igg/BBD9000/Kiosk/SmartIO/hardware/v3.3/SmartIOv3.3-brd.png

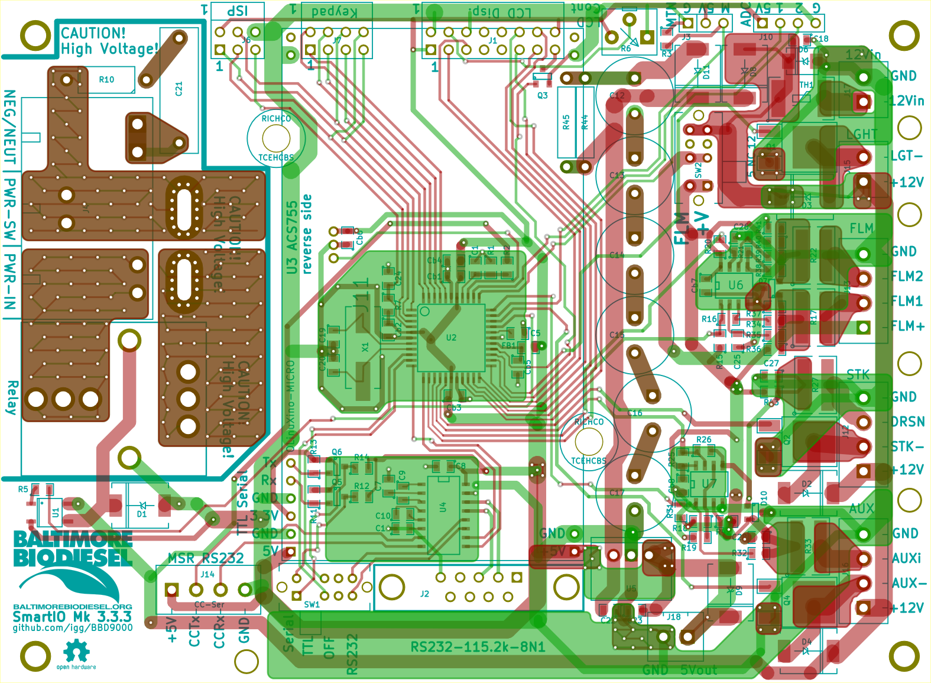
Kiosk/SmartIO/hardware/v3.3/SmartIOv3.3-brd.png
