igg/BBD9000/Kiosk/README.md

#### ARM-SBC
* Software running on a single-board solid-state Linux computer for interfacing between SmartIO board and BBD9000-CMS.

#### SmartIO
* Hardware design files and AVR firmware
