igg/BBD9000/Kiosk/SmartIO/hardware/README.md

### SmartIO v3.2
  * Original board manufactured by Baltimore Biodiesel Coop.
  * Through-hole, hand-soldered design.
  * PC-104 form-factor.
  * Requires external PC-104 5V power supply board.
  * Pad2Pad proprietary design files.

### SmartIO v3.3 and beyond
  * Designed using [KiCad EDA software] (http://www.kicad-pcb.org/) (free/open-source, Mac, Linux, Windows)
  * Mostly SMT components
  * Header/footprint for newer ARM CPU board (currently [Olimex iMX233-OLinuXino-Micro] (https://www.olimex.com/Products/OLinuXino/iMX233/iMX233-OLinuXino-MICRO/))
  * TTL-serial comms with ARM CPU via header (on board TTL voltage level shifter)
  * On-board 5V 2A switching power supply module, supplies ARM CPU via header
