igg/BBD9000/Kiosk/Case/Panel-AM1084-8-hole-no-components.pdf

Origin

Cutout: Square
X=9.100"; Y=10.145"
W = 0.20"; H = 0.20"

Cutout: Square
X=3.700"; Y=10.145"
W = 0.20"; H = 0.20"

r = 0.40"

## Round-corner panel 14 ga. (alt: 12 ga.) Stainless

W = 13.00"; H = 11.12" (-0.0"/+0.1")

## Corner radius = 0.40"

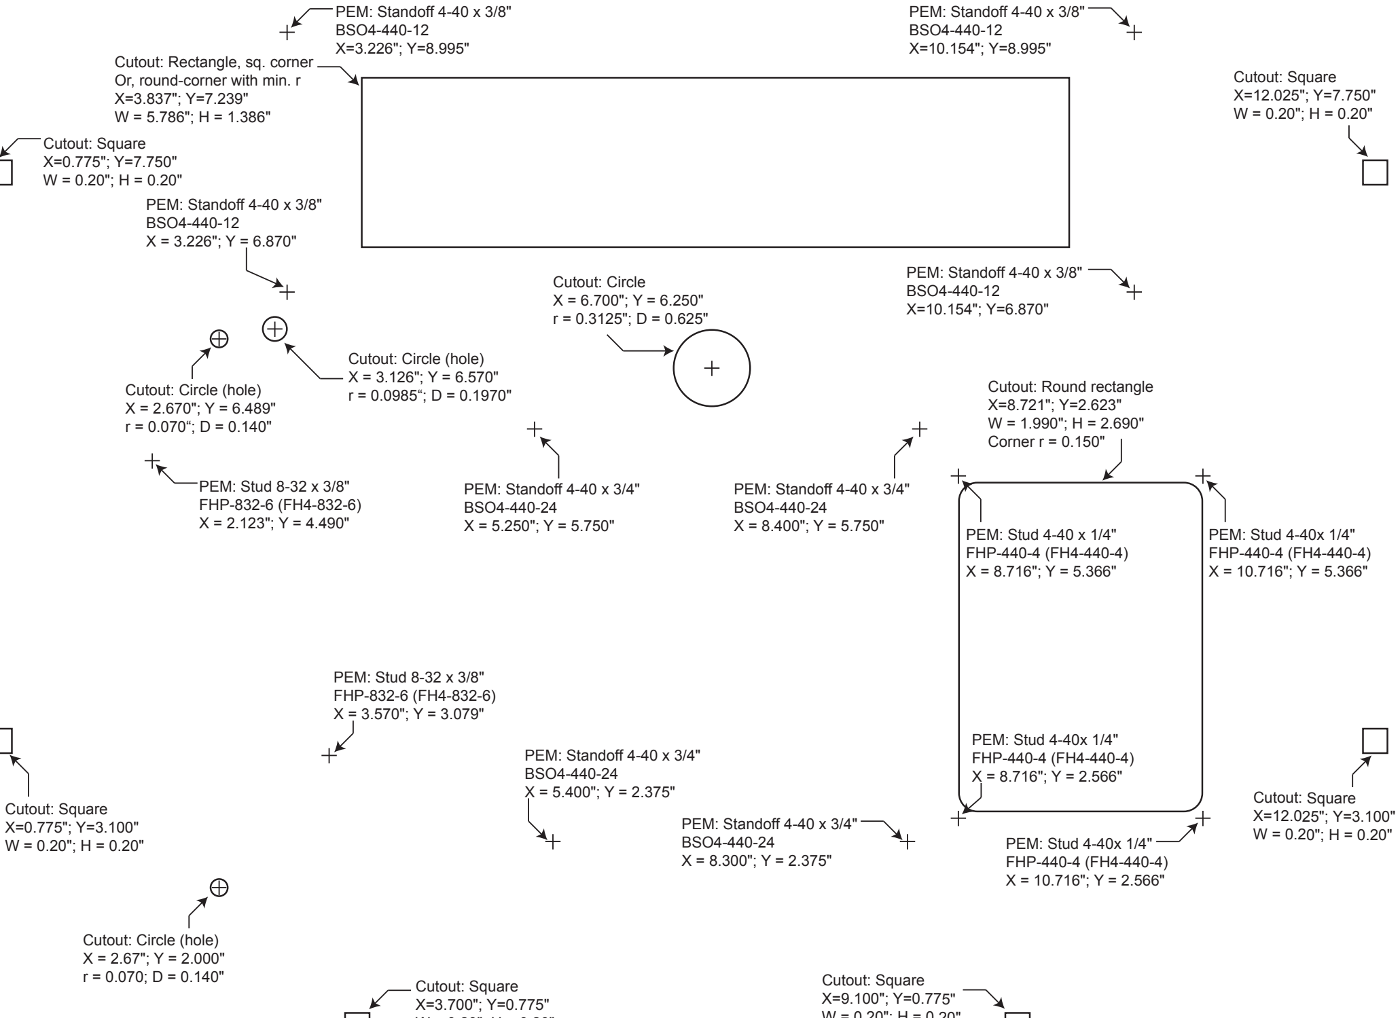
[picture p3: figure]
Cutout: Square X=0.775"; Y=7.750" W = 0.20"; H = 0.20"; PEM: Standoff 4-40 x 3/8" BSO4-440-12 X=3.226"; Y=8.995"; PEM: Standoff 4-40 x 3/8" BSO4-440-12 X=10.154"; Y=8.995"; PEM: Standoff 4-40 x 3/8" BSO4-440-12 X=10.154"; Y=6.870"; PEM: Standoff 4-40 x 3/8" BSO4-440-12 X = 3.226"; Y = 6.870"; Cutout: Rectangle, sq. corner Or, round-corner with min. r X=3.837"; Y=7.239" W = 5.786"; H = 1.386"; Cutout: Circle X = 6.700"; Y = 6.250" r = 0.3125"; D = 0.625"; PEM: Stud 8-32 x 3/8" FHP-832-6 (FH4-832-6) X = 2.123"; Y = 4.490"; PEM: Stud 8-32 x 3/8" FHP-832-6 (FH4-832-6) X = 3.570"; Y = 3.079"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

W = 0.20"; H = 0.20"

W = 0.20"; H = 0.20"

NOTE: Face-on view; PEMs stick out the back side.
* Origin at lower-left.
* PEM positions are to the center of the PEM.
* Round cutout positions are to the center of the cutout.
* Square cutout positions to the lower-left corner of the cutout.
