igg/BBD9000/Kiosk/SmartIO/hardware/v3.3/SmartIOv3.3-BOM.ods

Id | Designator | Package | Quantity | Designation | Supplier and ref | Alt | New in 3.3.2
Power switching
2 | K1 | relay-CB1AH | 1 | CB1aH-P-12V | 255-2177-ND
43 | J4 | MOLEX-39910-0103-3circ | 1 | 39910-0103 | WM5965-ND
Terminals
26 | J12,J13,J14,J16 | OSTTE-4 | 4 | STK, FLM, CC-Ser, AUX | ED2742-ND |  | *
32 | J15,J17,J18 | OSTTE-2 | 3 | LGHT, 12Vin, 5Vou | ED2740-ND |  | *
5 | J2 | DB9FD | 1 | DB9
Through-hole
44 | R10 | R4 | 1 | 120 | RC12JB100R-ND
45 | C21 | C-X2-15mm | 1 | 0.1uF | 399-5426-ND
48 | R6 | POTX | 1 | 10k | DCA14CT-ND
25 | C12,C13,C14,C15,C16,C17 | C2V10 | 6 | 10F | 1182-1009-ND
46 | U3 | Allegro_HallSensor_CB-PFF | 1 | ACS758LCB-050U | 620-1353-ND
34 | U5 | V78XX-2000 | 1 | 5V-2A-PSU-V7805-2000 | 102-2175-ND
1 | SW1,SW2 | SW_DP3T | 2 | SW-DP3T | EG1913-ND |  | *
Headers,male 2-row, right-angle 30-pos total |  |  |  |  | A32706-40-ND |  | *
36 | J1 | pin_array_8x2_ra | 1 | LCD
50 | J6 | pin_array_3x2_ra | 1 | ISP Hdr
35 | J7 | pin_array_4x2_ra | 1 | Keypad
Headers, male 1-row male 7-pos total |  |  |  |  | A26513-40-ND
33 | J3 | PIN_ARRAY_3X1 | 1 | MTN
23 | J10 | PIN_ARRAY_4x1 | 1 | ADC
Headers, female 1-row 3x2-pos, 1x6-pos
42 | J11 | OLinuXino-MICRO-min | 1 | TTL UART | S7039-ND | 3M9517-ND
-- | Jxx | header-f-1x2-pth | 3 | 2x1 mounting headers | S7035-ND
SMD components
20 | X1 | HC49-US | 1 | 18.432 MHz | 631-1209-1-ND
3 | U1 | SOP4 | 1 | CPC1002N | CLA230CT-ND
47 | U2 | TQFP44-ATMega324 | 1 | ATMEGA324PA-A | ATMEGA324PA-AURCT-ND
4 | U4 | SO16N | 1 | MAX232 | 296-26141-1-ND
6 | U6,U7 | LM193 | 2 | LM193 | 296-31647-1-ND |  | *
22 | TH1 | PTC2920 | 1 | PTC-3A | MF-LSMF300/24X-2CT-ND |  | *
24 | Q1,Q2,Q4 | DPAK2 | 3 | NTD5806NT4G | NTD5806NT4GOSCT-ND |  | *
37 | Q3,Q5,Q6 | SOT23-BSS138K | 3 | BSS138K | BSS138KCT-ND
21 | D6 | DO-214AA-TVS | 1 | TVS-13V | 1SMB13AT3GOSCT-ND |  | *
8 | D7,D10 | SOT23 | 2 | TVS-15V | GSOT15C-GS08CT-ND |  | *
38 | D1,D2,D3,D4,D8,D9 | DO-214AB | 6 | STPS5L60 | 497-8487-1-ND |  | *
7 | R17,R22,R27,R33 | SM2512W-1225 | 4 | 5k 2W PR | RCL4.99KECT-ND |  | *
9 | R2,R7,R11,R12,R13,R14,R19 | SM0805 | 7 | 10k | RR12P10.0KDCT-ND
10 | R1 | SM0805 | 1 | 3.4k | RR12P3.4KDCT-ND
11 | Cb1,Cb2,Cb3,Cb5,Cb6,Cb7,Cb8,C1,C5,C24 | SM0805 | 10 | 0.1uF | 1276-1007-1-ND
12 | Cb4,C18,C22 | SM0805 | 3 | 10uF | 490-5523-1-ND
13 | FB1 | SM0805 | 1 | 1kOhm@100MHz | 490-1041-1-ND
14 | R5 | SM0805 | 1 | 1k | RR12P1.0KDCT-ND
15 | C7,C8,C9,C10,C11 | SM0805 | 5 | 1uF | 311-1358-1-ND
16 | C19,C20 | SM0805 | 2 | 22pF | 399-1113-1-ND
17 | R3,R16,R21,R26,R32 | SM0805 | 5 | 56.2k | RR12P56.2KDCT-ND
18 | C23 | SM0805 | 1 | 22uF | 1276-2910-1-ND | 445-14428-1-ND
19 | C25,C26,C27,C28 | SM0805 | 4 | 0.2uF 50V | 1276-2948-1-ND | 0.02 uF: 1276-1081-1-ND | *
20 | R15,R18,R20,R25,R31,R34-R43 | SM0805 | 15 | 5k | RR12P5.1KDCT-ND |  | *
 |  | SMD components | 81
 |  | Through-hole | 32
Keypad connection
 | 8-pos 1-row 0.1” female, back of keypad | A31000-ND
 | 8-pos 2-row female for board header | 609-3570-ND
 | 8-pos ribbon cable 0.05”, 28 AWG | MD08R-5-ND
