igg/BBD9000/Kiosk/SmartIO/hardware/v3.3/SmartIOv3.3-sch.pdf

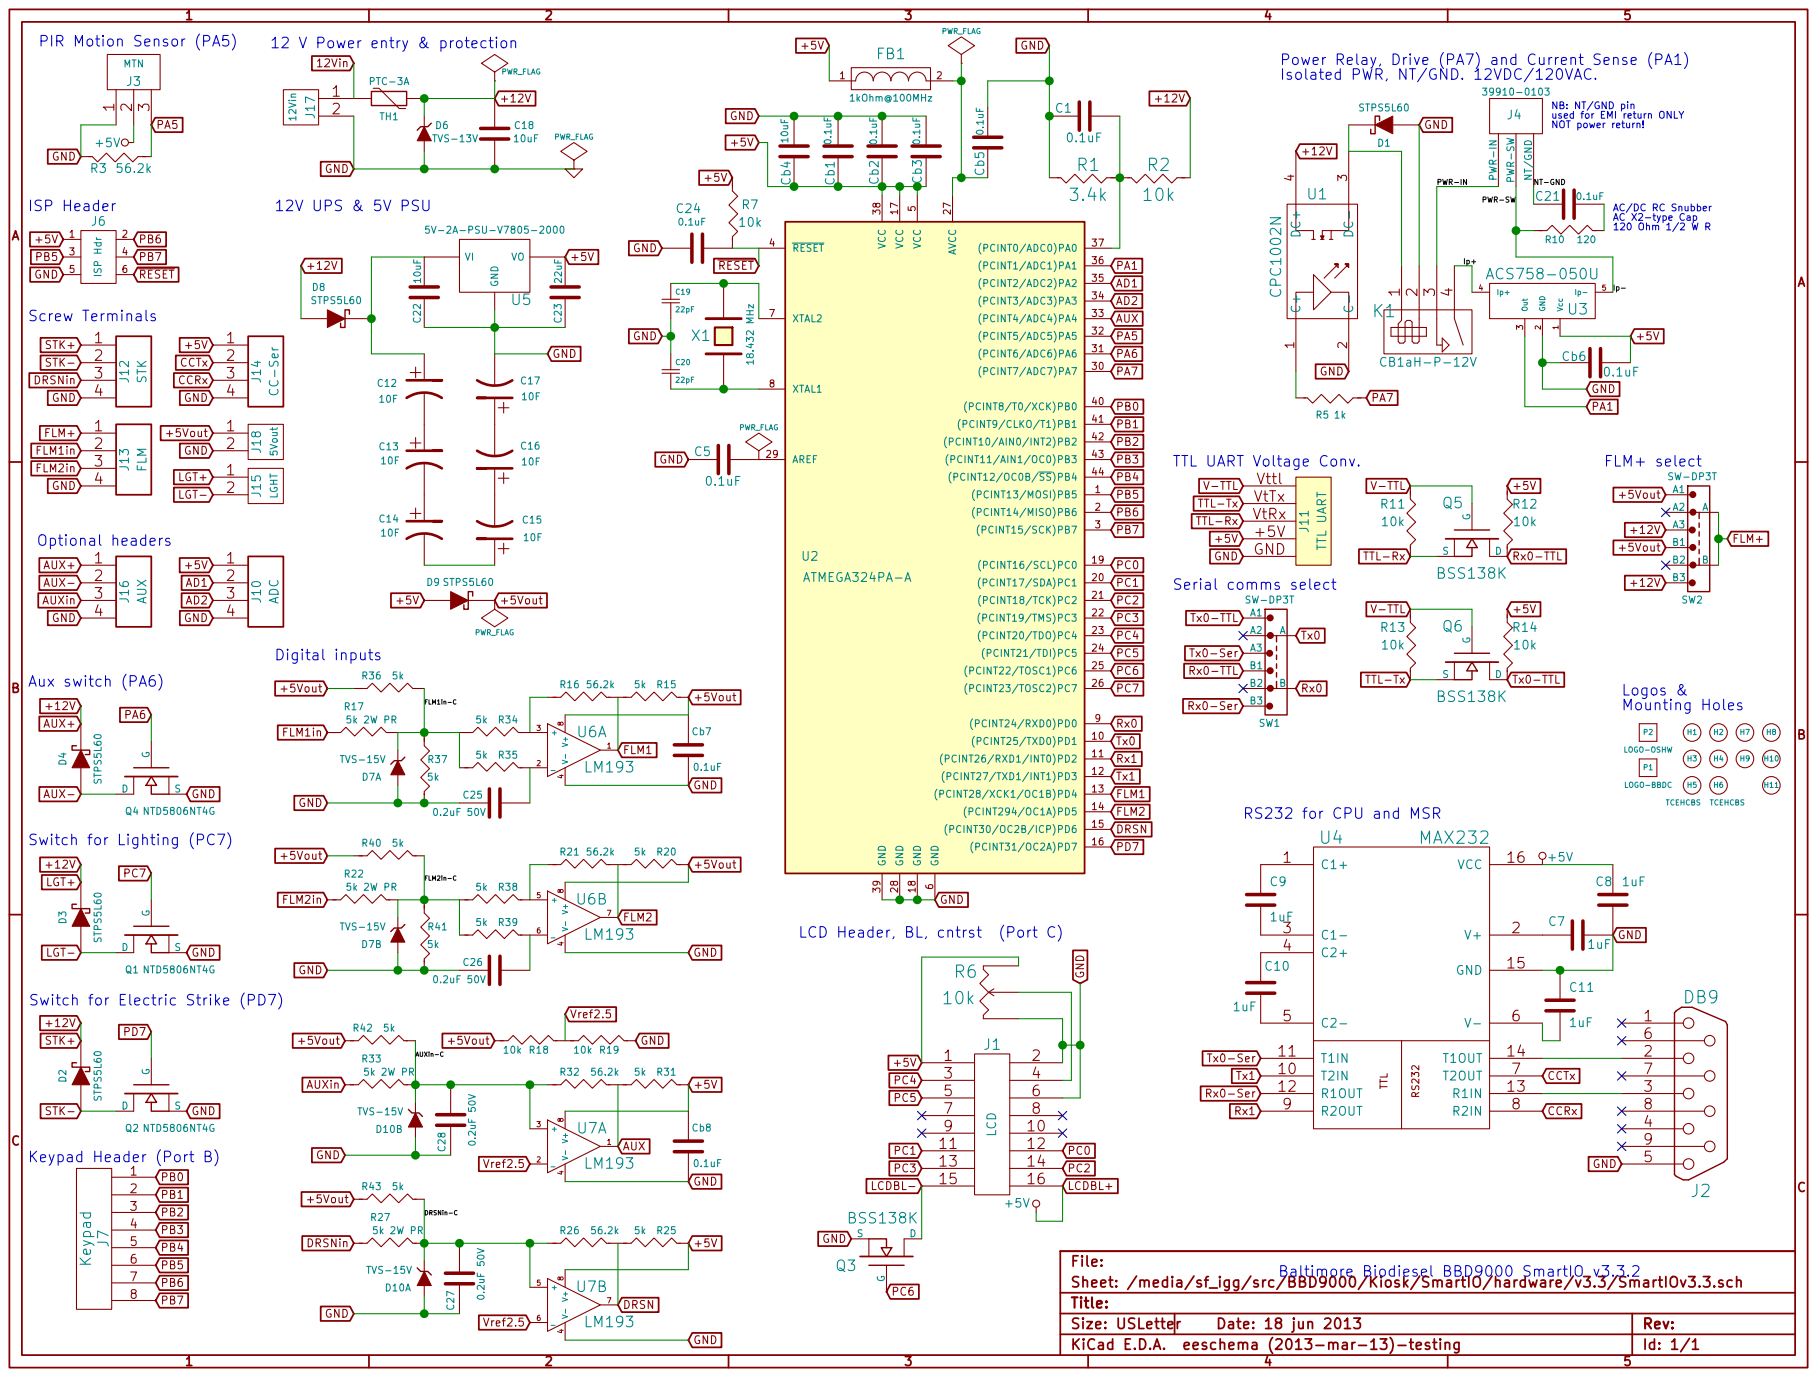
[picture p4: page 1]

Isolated PWR, NT/GND. 12VDC/120VAC.

NB: NT/GND pin

used for EMI return ONLY NOT power return! GND

NT-GND Cb7
10k Tx0-TTL +5V TTL UART Voltage Conv. C24

TVS-15V GND Digital inputs

RS232 for CPU and MSR

LCD Header, BL, cntrst (Port C)

Switch for Electric Strike (PD7)

C Sheet: /media/sf_igg/src/BBD9000/Kiosk/SmartIO/hardware/v3.3/SmartIOv3.3.sch File: Title:
