igg/BBD9000/Kiosk/SmartIO/hardware/v3.3/SmartIOv3.3-brd.pdf

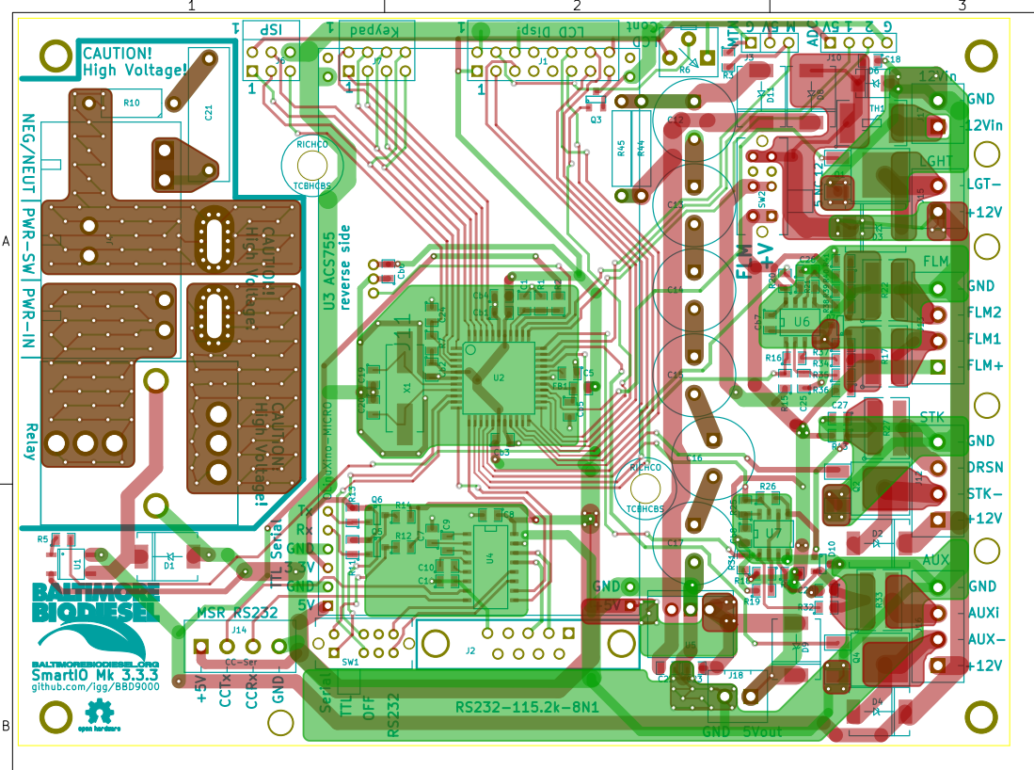
[picture p5: page 1]
