igg/BBD9000/Kiosk/SmartIO/hardware/v3.3/SmartIOv3.3-assy.pdf

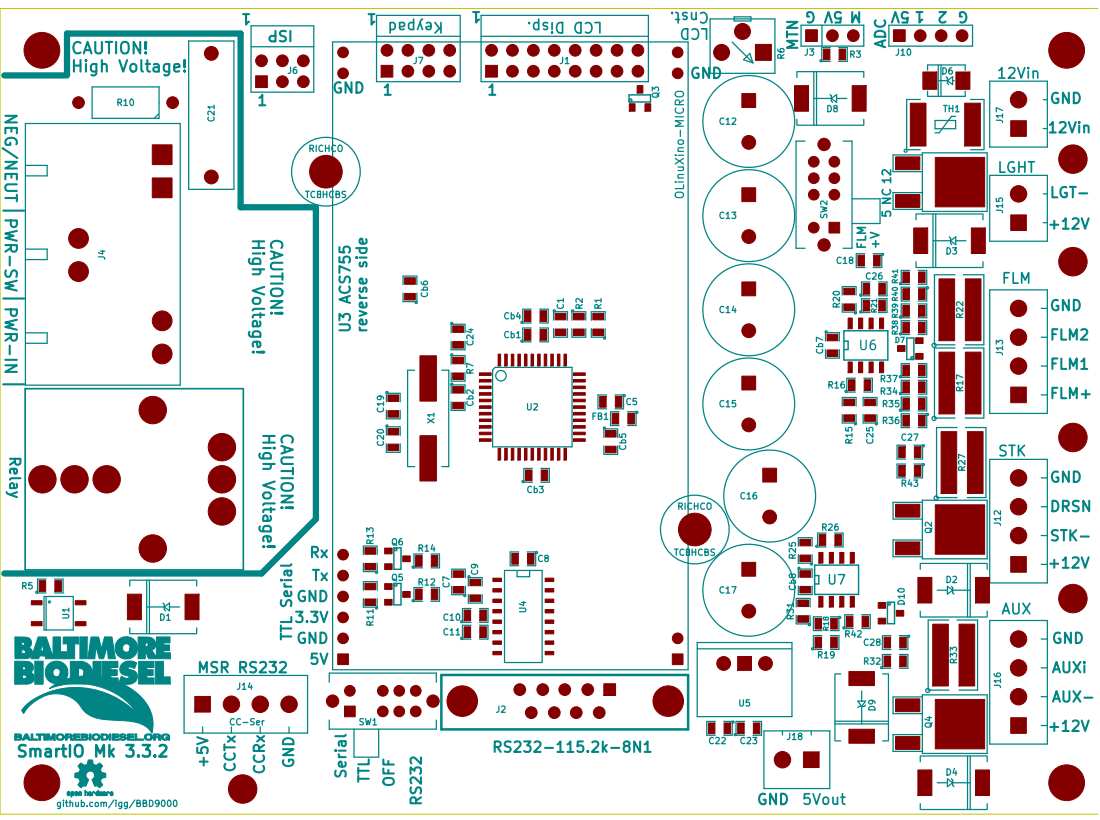
[picture p6: page 1]
