igg/BBD9000/Kiosk/Case/AM1084.pdf

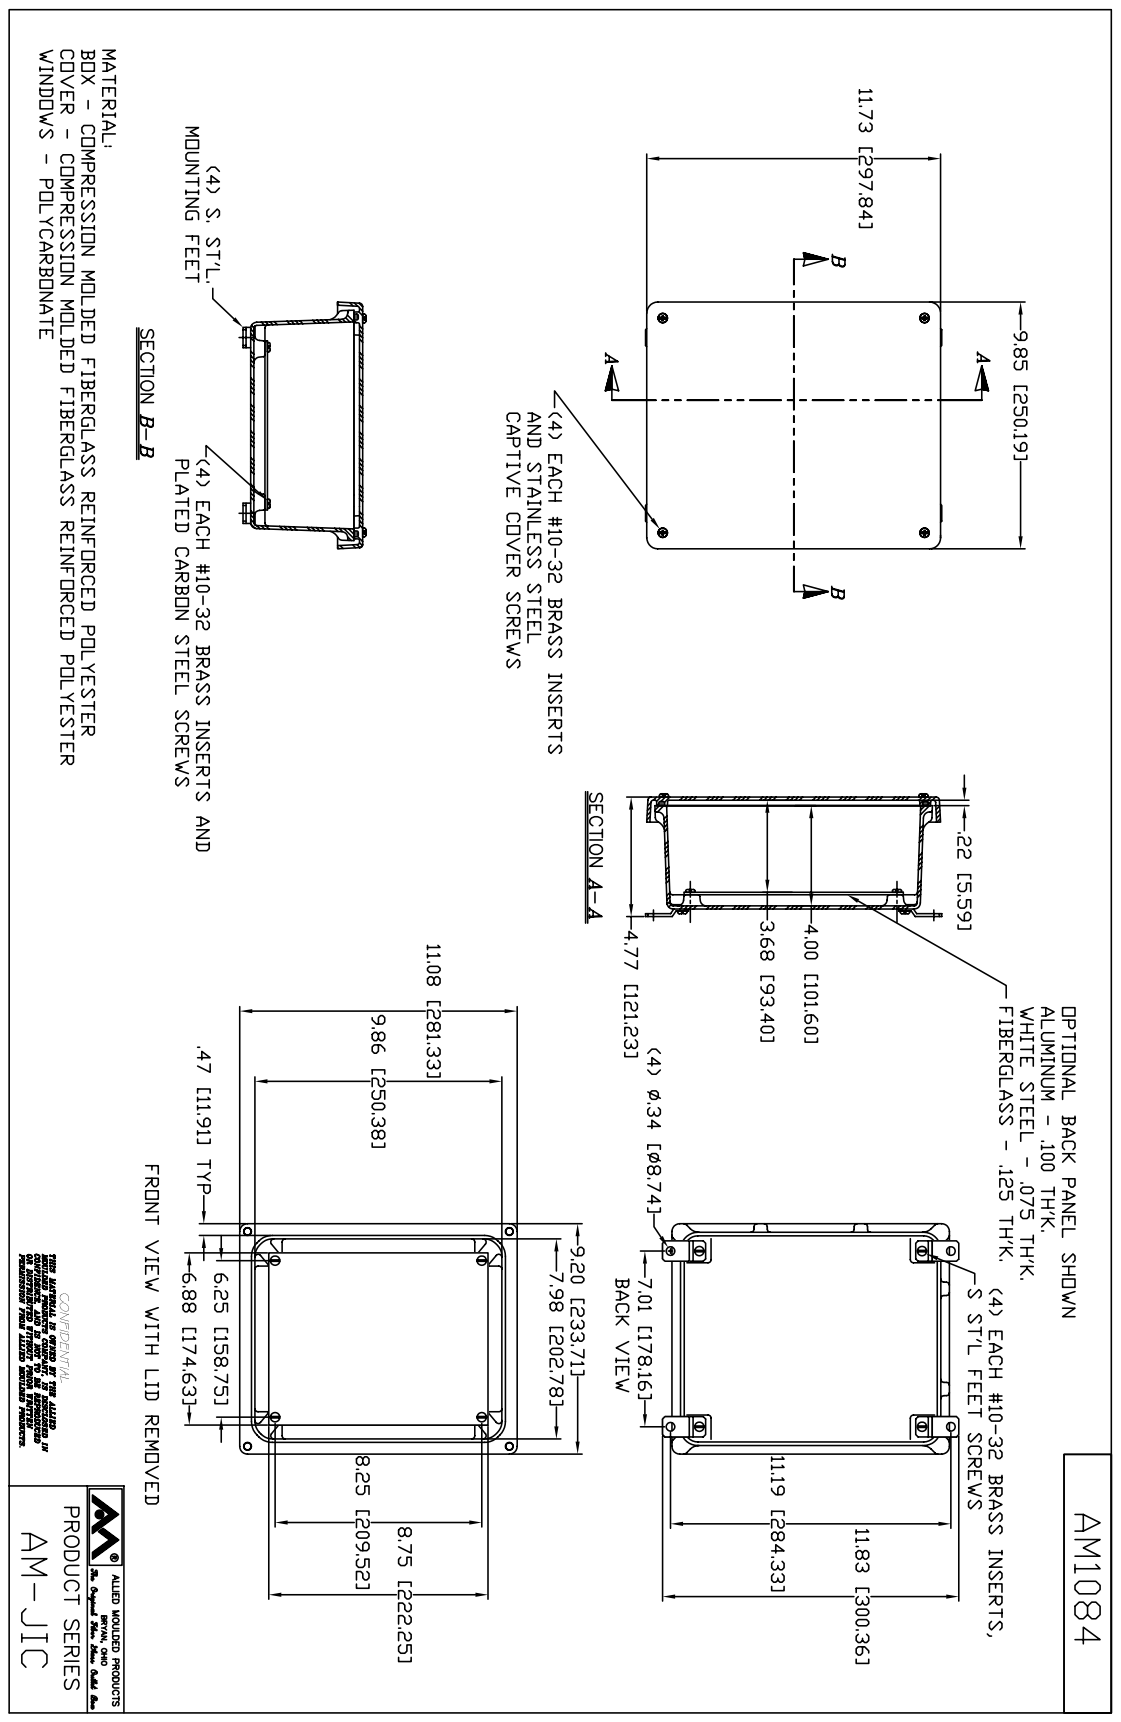
[picture p7: page 1]
