igg/BBD9000/Kiosk/SmartIO/hardware/v3.2/SmartIO-v3.2-Pad2Pad-color.pdf

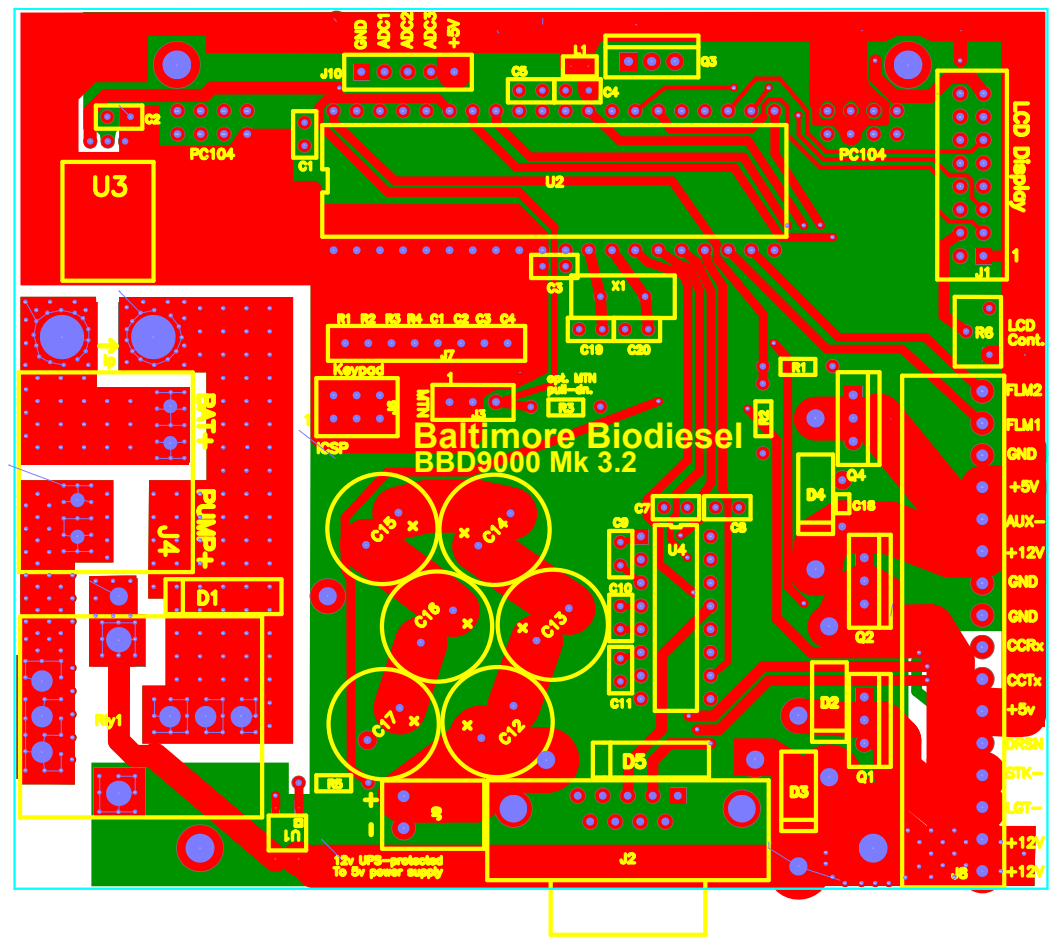
[picture p8: page 1]
BBD9000 Mk 3.2; Baltimore Biodiesel; Via; ViaVia
