igg/BBD9000/Kiosk/SmartIO/hardware/v3.2/SmartIO-v3.2-Schematic.pdf

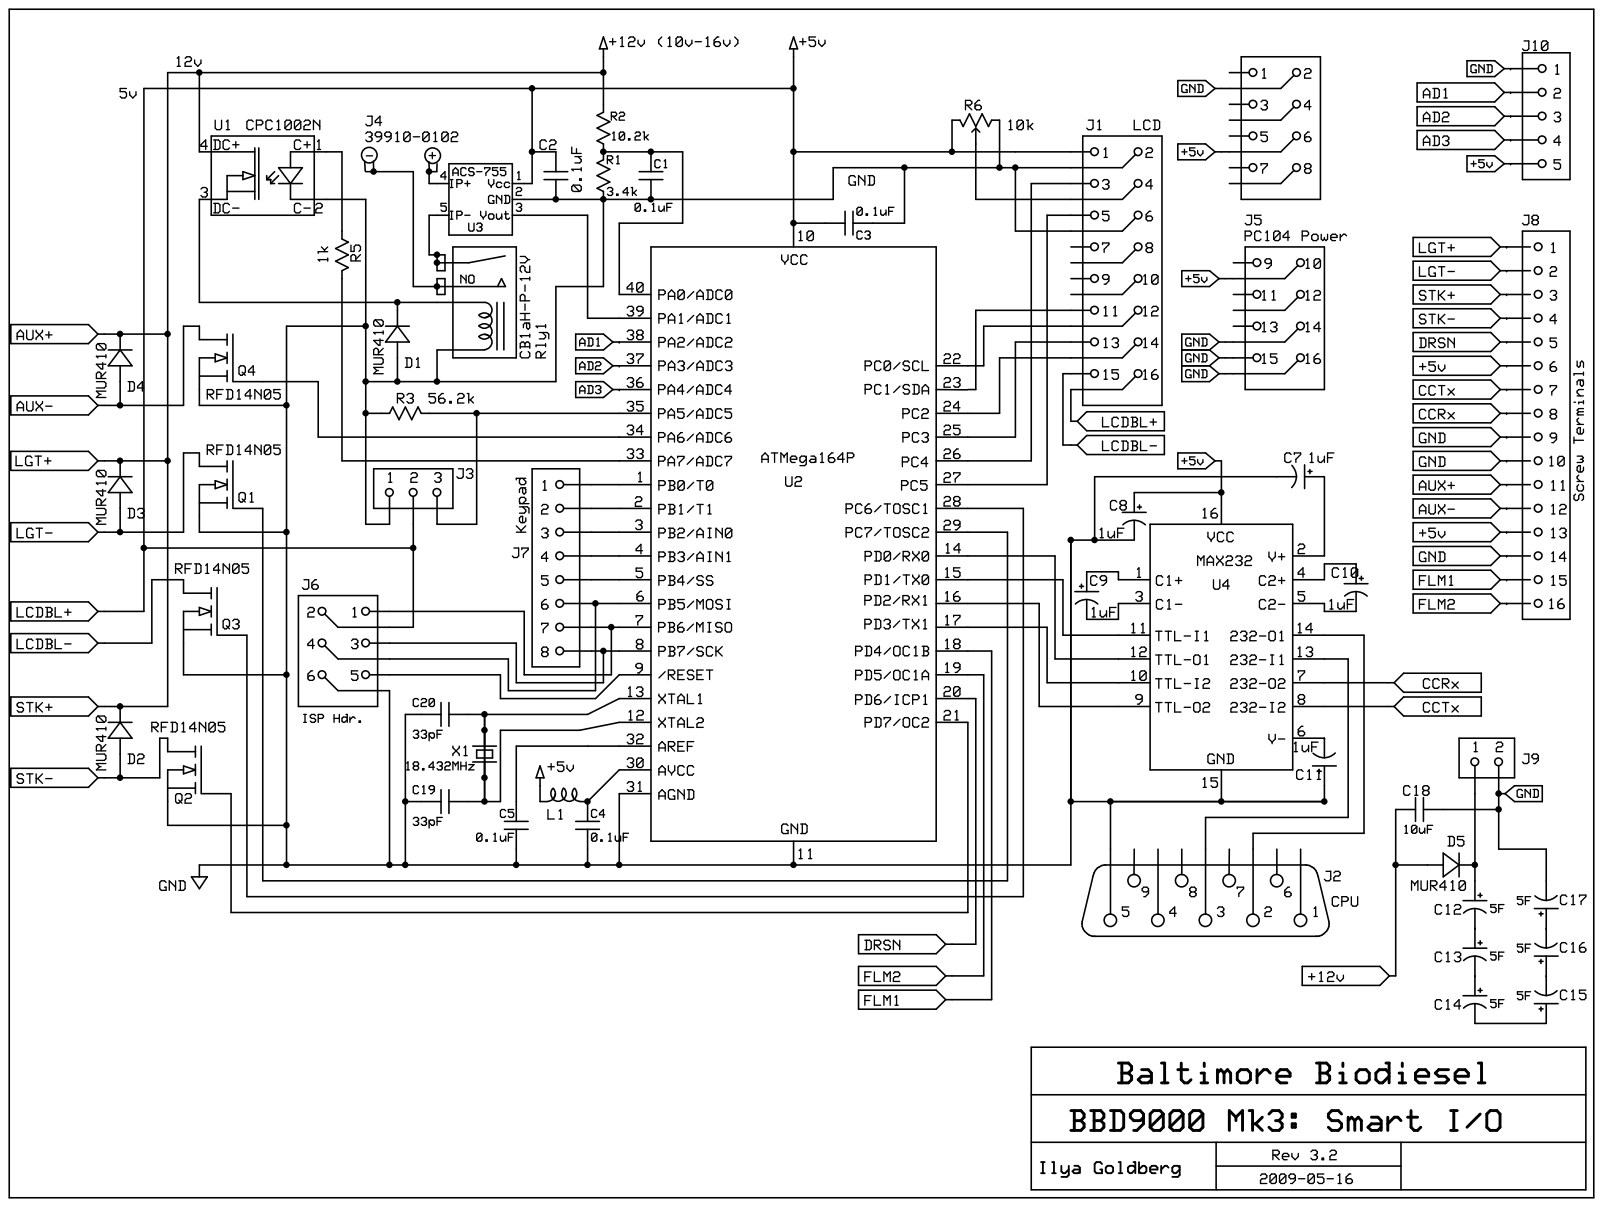
[picture p9: page 1]
