igg/BBD9000/(list of files, drawings)

Other design files:
Kiosk/SmartIO/hardware/v3.2/SmartIO-v3.2-Pad2Pad-ORDERED.pcb
Kiosk/SmartIO/hardware/v3.3/SmartIOv3.3.dsn
