igg/BBD9000/(commit log)

2013-05-22 Initial commit to set up directory/file structure
    [SmartIOv3.3.kicad_pcb, SmartIOv3.3.sch]
2013-05-23 Added AVR bootloader source
    [SmartIO-v3.2-BOM-Digikey.ods, SmartIO-v3.2-BOM-ExpressSCH.ods, fboot21.obj]
2013-05-23 Added Pad2Pad files for SmartIOv3.2
    [SmartIO-v3.2-ExpressSCH.sch, SmartIO-v3.2-Pad2Pad-ORDERED.pcb]
2013-05-23 renamed Kiosk/BBD9000 to Kiosk/ARM-SBC
2013-05-23 Added README for ARM-SBC source
2013-05-24 Added mod files for PCB
    [SmartIOv3.3.sch]
2013-06-13 added schematic pdf
2013-06-20 Added RC snubber, additional bypass caps for SMD AVR
    [SmartIOv3.3.sch]
2013-06-20 Initial board layout
    [SmartIOv3.3.kicad_pcb]
2013-06-20 miscellaneous synch from switching versions
    [SmartIOv3.3.dsn]
2013-06-20 Added 5v sw PSU module V78XX-2000
    [SmartIOv3.3.kicad_pcb, SmartIOv3.3.sch]
2013-06-20 PSU needs caps
    [SmartIOv3.3.kicad_pcb]
2013-06-20 Fixed snubber and power terminal connections
    [SmartIOv3.3.sch]
2013-06-20 New layout for current sensor on flip side of board
    [SmartIOv3.3.kicad_pcb]
2013-06-22 Added OLinuXino-MICRO header, made a pre-module-packing version of the board
    [SmartIOv3.3-modules-pre-assy.kicad_pcb, SmartIOv3.3.sch]
2013-06-30 Final layout, electrical check OK, needs manual check
    [SmartIOv3.3.kicad_pcb, SmartIOv3.3.sch]
2013-06-30 Made old PCB actual size
2013-06-30 Moved screwholes. Ready to print?
    [SmartIOv3.3.kicad_pcb]
2013-06-30 Comitted gerbers
    [SmartIOv3.3-B_Cu.gbl, SmartIOv3.3-B_Mask.gbs, SmartIOv3.3-Edge_Cuts.gbr, SmartIOv3.3-F_Cu.gtl, SmartIOv3.3-F_Mask.gts, SmartIOv3.3-F_SilkS.gto, SmartIOv3.3.drl]
2013-07-01 Chnaged xtal caps to 22pf, fixed last board electrical checks
    [SmartIOv3.3-BOM.csv, SmartIOv3.3-BOM.ods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]
2013-07-01 deleted csv version of BOM
    [SmartIOv3.3-BOM.csv]
2013-07-01 Updated BOM with DigiKey part numbers.
    [SmartIOv3.3-BOM.ods]
2013-07-04 Fixed Relay footprint (removed from paste layer, added to B-SilkS), added paste gerber
    [SmartIOv3.3-BOM.ods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]
2013-07-12 Added SmartIO wiring color code
2013-07-12 SmartIO AVR no longer using eeprom. Added no-DRSN option to configuration.
    [BBD9000SmartIO.c, BBD9000cfg.c, BBD9000fsm.c, BBD9000init.c, BBD9000mem.h, SmartIO.c, SmartIO.h, main.c]
2013-08-04 Changes to make v3.3.2 boards
    Added digital input protections, Vin protections, fixed footprints,
    using right-angle headers on top of board for keypad/lcd.
    [SmartIOv3.3-BOM.ods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]
2013-09-09 layout updates
    [SmartIOv3.3-BOM.ods, SmartIOv3.3.csv, SmartIOv3.3.kicad_pcb]
2013-09-13 increased timeout to wait for SmartIO reboot
    [BBD9000init.c]
2013-09-20 update universal FLM inputs in schematics (no board layout yet)
    [SmartIOv3.3.sch]
2013-09-26 started work on universal input layout
    [SmartIOv3.3.kicad_pcb]
2013-10-04 Rearranged bootloader location, replaced with avr-gcc implementation
    [fboot21.obj]
2013-10-12 Corrected footprints for Opto-relay U1, 2W Resistors, Switch
2013-10-12 Finished layout for dig. inputs, incorporated footprint corrections
    [SmartIOv3.3-BOM.ods, SmartIOv3.3.kicad_pcb, SmartIOv3.3.sch]
2013-10-12 Generated gerbers for v3.3.2
    [SmartIOv3.3-B_Cu.gbl, SmartIOv3.3-B_Mask.gbs, SmartIOv3.3-Edge_Cuts.gbr, SmartIOv3.3-F_Cu.gtl, SmartIOv3.3-F_Mask.gts, SmartIOv3.3-F_Paste.gtp, SmartIOv3.3-F_SilkS.gto, SmartIOv3.3.drl]
2013-11-09 New spreadsheet for board assembly
    [SmartIOv3.3-SMT-assy.ods]
2013-11-09 Updated assembly spreadsheet
    [SmartIOv3.3-SMT-assy.ods]
2013-11-10 corrected ISP header-rows were mirorred
    [SmartIOv3.3.kicad_pcb, SmartIOv3.3.sch]
2013-11-10 Made 1225 pads smaller
    [SmartIOv3.3.kicad_pcb]
2013-11-10 Changed via drll to 0.015, size to 0.3
    [SmartIOv3.3.kicad_pcb]
2013-11-12 Added Atmega324PA to bootloader device list
2013-11-12 Avoiding name conflict with CAL1
    Changed CAL1, CAL2, RAW1, RAW2, M, B to cal1, cal2, raw1, raw2, cal_m,
    cal_b.
    CAL1 was conflicting with a symbol defined in ATmega324PA include, so
    made everything else consistent with case change
    [SmartIO.c, SmartIO.h, main.c]
2013-11-19 Flowmeter calibration with more precision
2013-11-19 Fixed reversed TTL Rx/Tx
    [SmartIOv3.3.kicad_pcb, SmartIOv3.3.sch]
2013-11-20 Fixed olinuxino header pin#s & GND
    [SmartIOv3.3.kicad_pcb, SmartIOv3.3.sch]
2013-11-21 right angle headers twere oo close to each other
    Moved the keypad and lcd headers another ~0.150 mil appart
    [SmartIOv3.3.kicad_pcb]
2013-11-21 More copper to traces, zones
    [SmartIOv3.3.kicad_pcb]
2013-11-24 Fixed adc calibration function
    [SmartIO.h]
2013-11-24 changed calibration settings
2013-11-25 Changed R18 to 5k to make Vref 3.3V
    [$SmartIOv3.3.sch, SmartIOv3.3.kicad_pcb]
2013-11-25 Change drilli sze in C21 and R10 components
    [SmartIOv3.3.kicad_pcb]
2013-11-25 Fixed assy. spreadsheet and BOM to reflect 2.5V->3.3V Vref
    [$SmartIOv3.3.sch, SmartIOv3.3-BOM.ods, SmartIOv3.3-SMT-assy.ods, SmartIOv3.3-modules-pre-assy.kicad_pcb, SmartIOv3.3.sch]
2013-11-28 Simplified traces, added copper where possible
    [SmartIOv3.3.kicad_pcb]
2013-12-13 Added UPS charge current limiter, U7 on +5Vout
    Simple current limiter using two 75 ohm 3W resistors in parallel with a
    diode - charging through 37.5 ohm/6W, discharge through diode.
    [SmartIOv3.3.kicad_pcb, SmartIOv3.3.sch]
2014-02-19 No longer unlinking the run configuration - refreshing it on idle
    [BBD9000fsm.c]
2014-02-19 Logo modifications
    [SmartIOv3.3.kicad_pcb]
2014-02-19 Added power protection discussions
2014-02-26 Minor display corrections synchronized from on-line kiosks
    [BBD9000fsm.c]
2014-03-09 Slight reduction in uart0 rx/tx buffers
2014-03-10 Updated board drawings
2014-03-10 Fixed case in components for latest eeschema
    [SmartIOv3.3.sch]
2014-04-09 lower draw resistors in low-voltage-cutoff voltage divider
2014-10-01 top-center and right bolt cutouts 0.05 too high
2014-10-11 Move PSU-mount standoffs, update template
2015-08-27 Allowing single quotes in CGI param filter
