igg/BBD9000/(notices)

Notices in the files:
Kiosk/ARM-SBC/src/BBD9000server.c:
modify it under the terms of the GNU General Public License
